Sparxx947/shelly-treppenlicht/gehaeuse/treppenlicht-gehaeuse-p1s.3mf

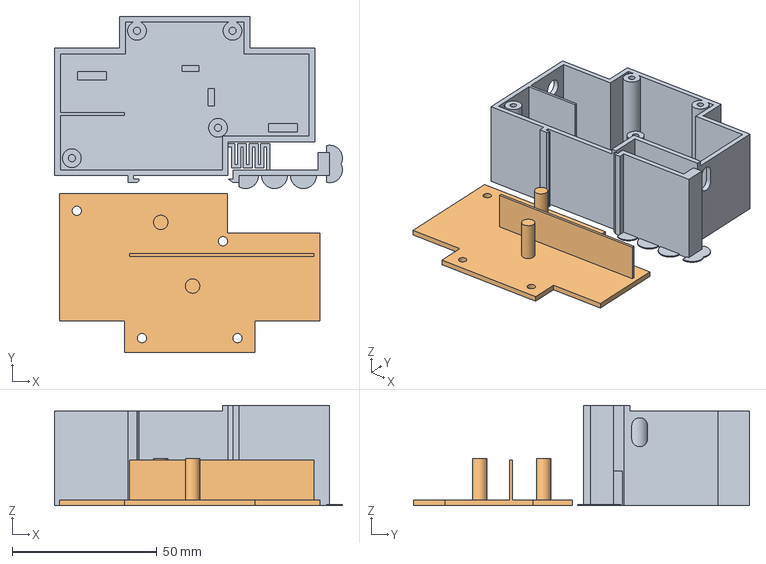
[picture p3: CAD file, 2026-11-02]
gehaeuse/treppenlicht-gehaeuse-p1s.3mf
99.5 x 116.2 x 34.6 mm
Gehaeuse Koerper (auf der Seite)
Gehaeuse Deckel
