Sparxx947/shelly-treppenlicht/gehaeuse/treppenlicht_deckel.stl

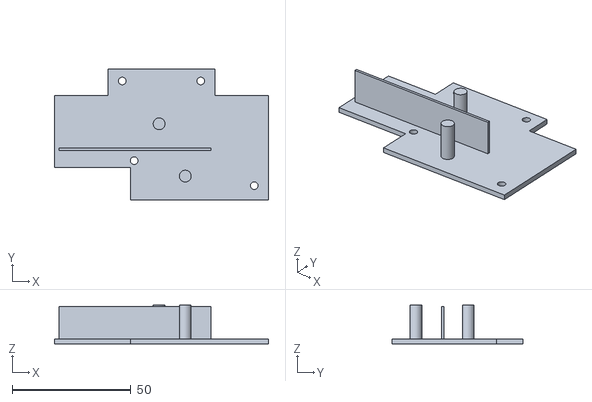
[picture p4: CAD file, 2026-11-02]
gehaeuse/treppenlicht_deckel.stl
90.0 x 55.0 x 16.3
