Sparxx947/shelly-treppenlicht/gehaeuse/treppenlicht_koerper.stl

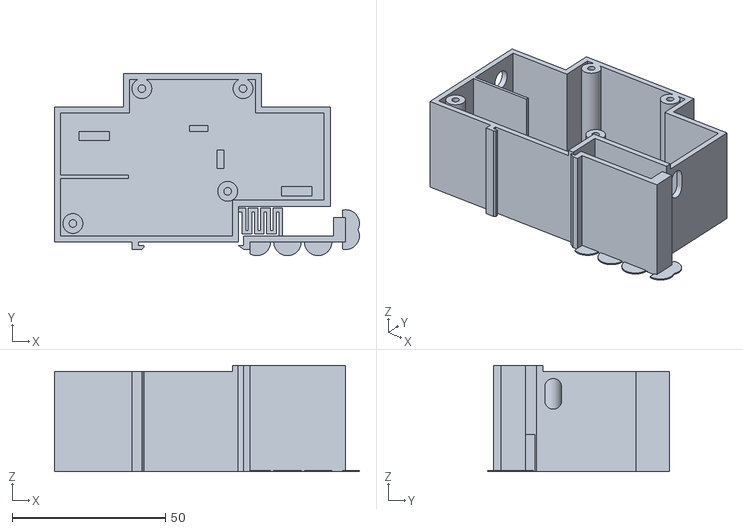
[picture p5: CAD file, 2026-11-02]
gehaeuse/treppenlicht_koerper.stl
99.5 x 59.5 x 34.6
