Sparxx947/shelly-treppenlicht/(commit log)

2026-11-02 Stairwell light: DIN-rail enclosure for Shelly 1 Mini Gen3
    Derived from shelly-tueroeffner (same Shelly, same housing). Bottom entry
    is a 5.5 x 10 mm slot for three single wires (I, O, SW), front label
    "Treppenlicht", new check pruef_loch (slot clear of latch block and lid
    divider, alarm path proven). README and enclosure docs in DE/EN.
    [treppenlicht-gehaeuse-p1s.3mf, treppenlicht-gehaeuse.scad, treppenlicht_deckel.stl, treppenlicht_koerper.stl]
2026-11-04 Document installation: ABB ESB20-11N terminals, Finder in BP mode, HA automation
    Status installed and tested (2026-11-04). Real relay terminals A1/A2, 1-2 NO,
    R3-R4 unused. Finder was in IT/IP and is now BP; it adds a full run time per
    press. Describe the motion automation and add the wiring diagram.
    Fixes #1
